ricklon/coglet/README.md

# Coglet

Coglet is a small talking robot head built to be an **MCP device for
[agent-hub](https://github.com/ricklon/agent-hub)**. It has a three-axis neck,
two-axis eyes, a shared top-lid servo, a jaw and two ears: nine hobby servos on
a PCA9685. There's a microphone and speaker for voice, and an optional camera on
the S3 build. The brain is a Seeed XIAO ESP32. The C3 runs this repo's own firmware, which
speaks the [xiaozhi-esp32](https://github.com/78/xiaozhi-esp32) protocol that
agent-hub serves; the S3 still runs a fork of xiaozhi-esp32 itself.

You don't program Coglet directly. It checks in with agent-hub, opens a voice
session, and advertises its abilities as MCP tools. The hub's persona hears what
people say, decides what to do, and calls `self.coglet.gaze`,
`self.coglet.animate` and the rest on the robot.

```
 person ──voice──▶ Coglet ──xiaozhi WebSocket (audio + MCP)──▶ agent-hub ──▶ LLM persona
                    ▲                                              │
                    └──────────── tools/call self.coglet.* ◀───────┘
```

## Supported boards

The S3 is the primary board and supports everything. The C3 and C6 can be used
with the project but can't do every feature. All three take the same wiring,
pad for pad ([hardware/WIRING.md](hardware/WIRING.md)).

| | S3 (XIAO ESP32-S3 Sense) | C3 (XIAO ESP32-C3) | C6 (XIAO ESP32-C6) |
|---|---|---|---|
| Role | Primary | Reduced | Reduced |
| Voice session, MCP tools, servo control | Yes | Yes | Builds; not run on a robot yet |
| Camera | Yes | No | No |
| Wake word | Yes ("Computer", or a phrase you choose) | No | No |
| Firmware | The xiaozhi-esp32 fork (`just build s3`) | This repo's `firmware/app` (`just build c3`) | This repo's `firmware/app` (`just build c6`) |
| Web Programmer build | `coglet` | `coglet-c3` | `coglet-c6` (untested on a robot) |

A tool change on one board is mirrored on the other, except tools that need the camera or the wake word.

| | |
|---|---|
| Coglet C3 (XIAO ESP32-C3) | On the bench, talking to agent-hub on the fork firmware; servos being fitted and calibrated from the base upward. The new `firmware/app` builds but hasn't run on the robot yet |
| Coglet S3 (XIAO ESP32-S3 Sense) | Builds, in two versions: wake word "Computer", or a phrase you choose ("Hey Coglet" to start). Detects its camera (OV2640, OV3660 or OV5640) at boot. Not yet physically qualified |
| Mechanism | Nine roles defined (confirmed 2026-09-15). Servos fitted one at a time; a partly built robot is normal |

No servo gives position feedback. Every position the firmware reports is the
last one it *commanded*, not a measurement. The **servo-rail switch is the
emergency stop**.

## Quick start

1. **Build it.** The [guided build](https://ricklon.github.io/coglet/) walks through parts, flashing, wiring one wire at a time, checks, agent-hub and calibration. The same steps are in [docs/ASSEMBLY.md](docs/ASSEMBLY.md); pins are in
   [hardware/WIRING.md](hardware/WIRING.md). The Fritzing
   schematic is [hardware/esp32c3-voice-agent.fzz](hardware/esp32c3-voice-agent.fzz)
   (older than the pad map in WIRING.md; the pad map wins).
2. **Flash it.** Servo supply off. Use the Web Programmer
   (Chrome or Edge), or build from source:
   ```bash
   just build c3     # firmware/app (or c6, for the XIAO ESP32-C6)
   just flash c3 /dev/ttyACM0
   just setup        # S3 only: fetch the xiaozhi-esp32 fork (submodule)
   just build s3     # or s3-phrase: your own wake phrase
   ```
   Details, including how to run the Web Programmer locally, are in
   [docs/FLASHING.md](docs/FLASHING.md).
3. **Connect it to agent-hub.** On the serial console:
   ```
   !wifi YourSSID YourPassword
   !server http://HUB_HOST:8003/xiaozhi/ota/
   ```
   It shows up on the hub dashboard with its `self.coglet.*` tools. See
   [docs/AGENT-HUB.md](docs/AGENT-HUB.md).
4. **Calibrate before anything moves.** Every boot is released with no roles
   mapped. Map and measure each servo, one at a time:
   [docs/CALIBRATION.md](docs/CALIBRATION.md).

## MCP tools

What agent-hub, Claude or any MCP client can call. MCP is the robot's one
interface: every command is a tool.

| Group | Tools |
|---|---|
| Motion (engaged) | `self.coglet.gaze`, `head`, `jaw`, `ears`, `lids`, `blink`, `animate` |
| Stopping | `self.coglet.stop`, `release` |
| Modes | `self.coglet.engage`, `calibrate` |
| Calibration (released or calibration mode) | `self.coglet.fit`, `configure`, `lid_coupling`, `identify`, `explore`, `nudge`, `mark`, `confirm`, `save`, `servo`, `jog`, `test` |
| Diagnostics | `self.coglet.state`, `export`, `scan` |
| Voice and audio | `self.voice.quiet`, `self.voice.restart`, `self.voice.wake_word` (S3), `self.audio_speaker.set_volume`, `self.audio_speaker.test_tone`, `self.audio_mic.status`, `self.audio_mic.set` |
| Device | `self.get_device_status`, `self.device.status`, `self.wifi.list`, `self.wifi.add`, `self.wifi.remove`, `self.hub.set_server`, `self.reboot` |

Both boards have every tool; a few S3 arguments are strings (see
[OPERATION.md](docs/OPERATION.md#device-commands)). The S3 adds
`self.camera.take_photo` when a camera is detected.

Animations: `look`, `roll`, `side_eye`, `wink`, `surprise`, `sleepy` for the
eyes; `nod`, `shake`, `tilt`, `perk`, `droop`, `talk`, `look_around` for the
rest of the head. Every position stays inside each servo's calibrated window.
Anything with hub access can engage the robot, so the **servo-rail switch**
is the stop that doesn't depend on software. The full list, with the serial
form of each command, is in [docs/OPERATION.md](docs/OPERATION.md#robot-commands).

## Repository layout

```
firmware/
  app/                 C3 firmware: Wi-Fi, agent-hub check-in, voice session, Opus, MCP, console
  coglet_controller/   servo controller: PCA9685, calibration, motion, animations
  tests/               host tests: the real controller against a fake ESP-IDF
  xiaozhi-esp32/       submodule: the xiaozhi fork, still used for the S3
hardware/              Fritzing schematic, wiring and parts
web-programmer/           the guided build site: overview, parts, flashing (esp-web-tools), wiring guide, serial console
scripts/               firmware packaging for the Web Programmer and releases
tools/                 calibration restore-command generator
docs/                  agent-hub, operation, calibration, flashing, qualification
```

On the C3, everything is in this repo: `firmware/app` speaks agent-hub's
xiaozhi protocol itself, with Opus from Espressif's `esp_audio_codec`. On the
S3, the voice stack, Wi-Fi, OTA and MCP server still come from the xiaozhi fork,
which holds a thin board layer. [docs/decisions.md](docs/decisions.md) explains
both.

## Documentation

**Follow current work:** [Build progress](docs/BUILD-PROGRESS.md) lists completed
milestones, the next action, pending input and the latest CAD preview.

Builder readiness, missing mechanical assets and the installation plan are
tracked in [docs/BUILD-REVIEW.md](docs/BUILD-REVIEW.md). CAD source conventions
live in [hardware/mechanical](hardware/mechanical/README.md), with
[SolidCraft CLI and MCP setup](docs/SOLIDCRAFT.md).

| Doc | What it covers |
|---|---|
| [docs/AGENT-HUB.md](docs/AGENT-HUB.md) | **Start here.** Check-in, MCP discovery, the tools, listen mode, driving Coglet from Claude Code |
| [docs/ASSEMBLY.md](docs/ASSEMBLY.md) | Putting it together: boards, harness, power, first power-up, servos base upward |
| [docs/CARRIER-STEPS.md](docs/CARRIER-STEPS.md) | The perfboard carrier, one link per step, with its [hole map](docs/CARRIER.md). Design, not yet built |
| [hardware/WIRING.md](hardware/WIRING.md) | Parts, pin maps for C3 and S3, power, `/OE`, bench checks |
| [docs/FLASHING.md](docs/FLASHING.md) | Web Programmer, CLI builds, packaging, releases, backups before reflashing |
| [docs/OPERATION.md](docs/OPERATION.md) | Every command (MCP tool and serial form), release/engage/calibrate, quiet mode |
| [docs/CALIBRATION.md](docs/CALIBRATION.md) | One-servo-at-a-time calibration, backup and restore |
| [docs/QUALIFICATION.md](docs/QUALIFICATION.md) | Staged physical bring-up checklist and the verification record |
| [docs/decisions.md](docs/decisions.md) | Why things are the way they are |
| [docs/roadmap.md](docs/roadmap.md) | What's done and what's next |
| [AGENTS.md](AGENTS.md) | Guidance for coding agents working in this repo |

## Related projects

- [will-cogley/Coglet](https://github.com/will-cogley/Coglet): Will Cogley's
  original mechanical design and print files. This build uses the version
  without TorqueStars, with our own electronics and agent-hub backend.
  C0_6_8 is the selected CAD baseline; non-TorqueStar adaptation is pending. See the
  [mechanical source inventory](hardware/mechanical/UPSTREAM.md).
- [agent-hub](https://github.com/ricklon/agent-hub): the server Coglet is built for.
- [ricklon/xiaozhi-esp32](https://github.com/ricklon/xiaozhi-esp32): the
  firmware fork, carried here as a submodule for the S3. The C3 firmware
  follows its protocol and storage layout.
- [eyemech-esp32-xiao](https://github.com/ricklon/eyemech-esp32-xiao): the
  animatronic eye project Coglet's motion keyframes and lid coupling were
  adapted from. Eyemech serves MCP over HTTP by itself, with no voice. Coglet
  rides the xiaozhi voice session instead.

## License

Unless otherwise marked, this project's original material is licensed under
**[CC BY-NC 4.0](https://creativecommons.org/licenses/by-nc/4.0/)**
(Creative Commons Attribution-NonCommercial 4.0 International).
See [LICENSE](LICENSE) for the full terms and [NOTICE.md](NOTICE.md) for scope,
upstream attribution and third-party exceptions.

Original Coglet mechanical designs are by Will Cogley / NMRobotics LTD and
retain their upstream CC BY-NC 4.0 notices. Third-party dependencies retain
their own licenses, including the MIT-licensed xiaozhi-esp32 submodule and
Espressif's `esp_audio_codec` under the Espressif Modified MIT license.
