ricklon/coglet/hardware/wires.csv

id | stage | from | to | suggested_colour | note
J1 | 1 | INMP441 L/R | INMP441 GND | black
J2 | 1 | MAX98357A GAIN | MAX98357A Vin | red | 6 dB gain
W1 | 3 | XIAO 3V3 | INMP441 VDD | orange
W2 | 3 | XIAO 3V3 | PCA9685 VCC | orange
W3 | 3 | XIAO 5V | MAX98357A Vin | red
W4 | 3 | XIAO GND | INMP441 GND | black
W5 | 3 | XIAO GND | MAX98357A GND | black
W6 | 3 | XIAO GND | PCA9685 GND | black
W7 | 4 | XIAO D0 | MAX98357A DIN | white
W8 | 4 | XIAO D1 | MAX98357A BCLK | yellow
W9 | 4 | XIAO D2 | MAX98357A LRC | green
W10 | 4 | MAX98357A + | Speaker + | red
W11 | 4 | MAX98357A − | Speaker − | black
W12 | 5 | XIAO D1 | INMP441 SCK | yellow
W13 | 5 | XIAO D2 | INMP441 WS | green
W14 | 5 | XIAO D3 | INMP441 SD | blue
W15 | 6 | XIAO D4 | PCA9685 SDA | violet
W16 | 6 | XIAO D5 | PCA9685 SCL | grey
W17 | 7 | XIAO D10 | PCA9685 /OE | brown
W18 | 8 | PCA9685 V+ | Servo supply V+ | red | through the switch
W19 | 8 | PCA9685 GND | Servo supply GND | black
