ricklon/coglet/hardware/mechanical/reference/parts/STRUCTURAL-PARTS.md

# Structural plate: isolated part views

Derived views of Will Cogley / NMRobotics LTD geometry, CC BY-NC 4.0.
See [upstream provenance](../../UPSTREAM.md). IDs refer to the pinned C0_6_8 pack.
Views are independently fitted, so image sizes cannot be compared as a scale.
Upstream names are preserved. Functional identifications require confirmation.

## C068-O20-P14 — Full - BottomPlug.stl

Mesh-local bounding box: 38.281 × 29.349 × 16.3 mm.

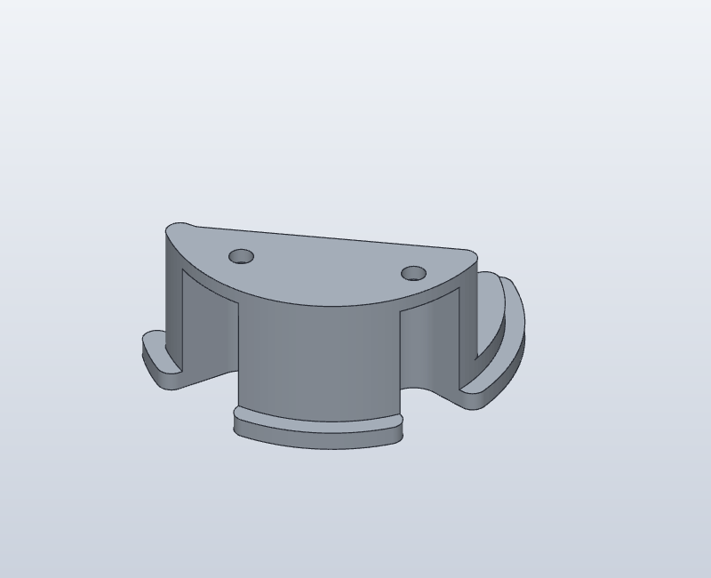
[picture p16: hardware/mechanical/reference/parts/C068-O20-P14.png]
C068-O20-P14


## C068-O20-P15 — Full.stl_7

Mesh-local bounding box: 99.533 × 97.237 × 75.793 mm.

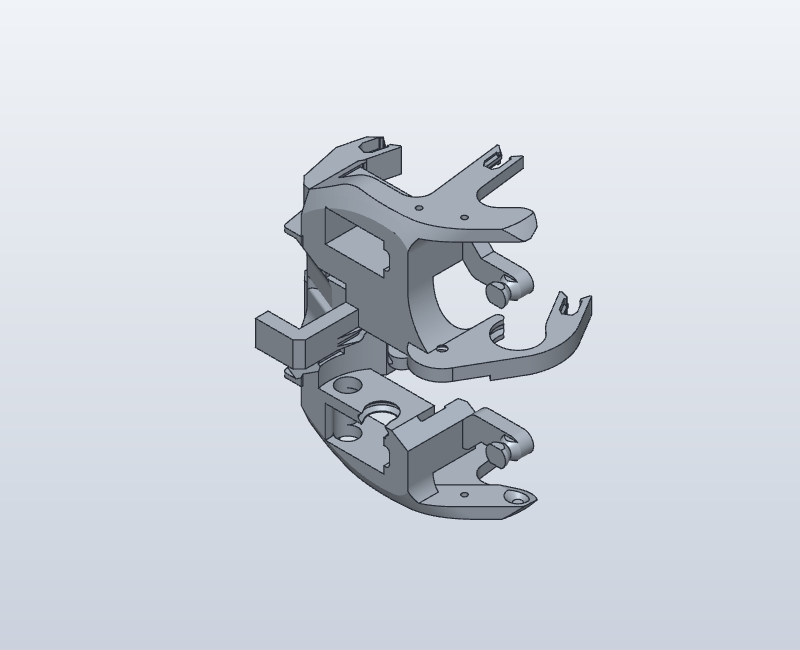
[picture p17: hardware/mechanical/reference/parts/C068-O20-P15.png]
C068-O20-P15


## C068-O20-P16 — Full - Part 24.stl

Mesh-local bounding box: 101.683 × 84.722 × 46.444 mm.

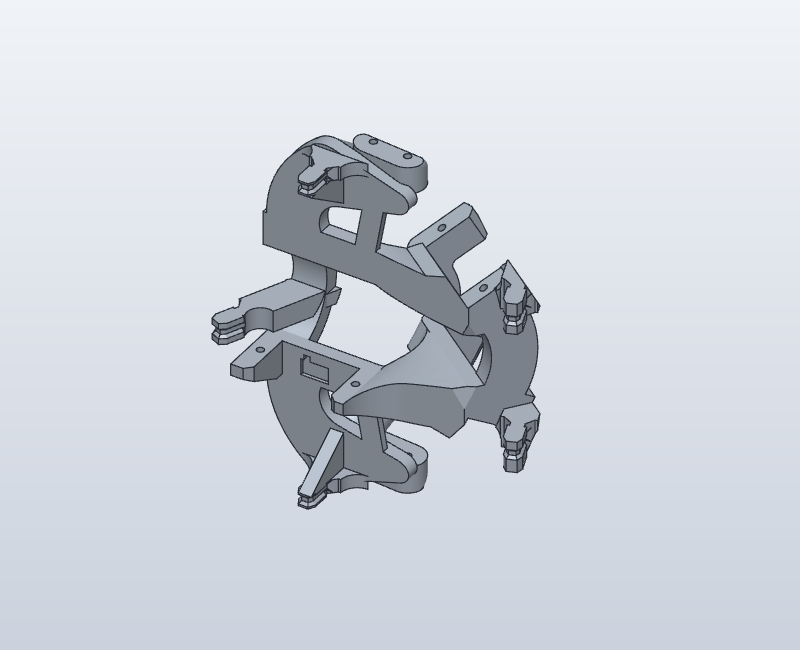
[picture p18: hardware/mechanical/reference/parts/C068-O20-P16.png]
C068-O20-P16


## C068-O20-P17 — Full - Foot (1).stl

Mesh-local bounding box: 92.0 × 92.0 × 27.75 mm.

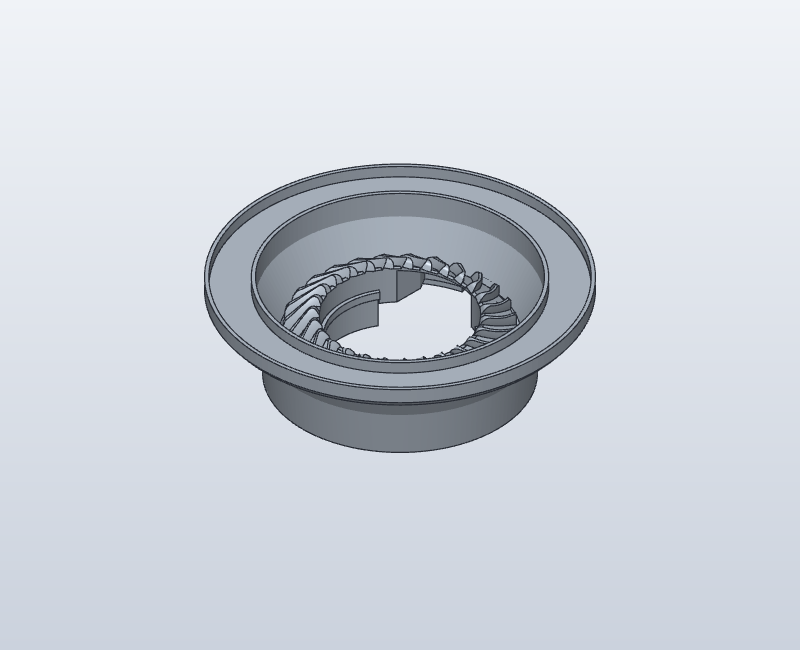
[picture p19: hardware/mechanical/reference/parts/C068-O20-P17.png]
C068-O20-P17


## C068-O20-P18 — Full (9).stl_3

Mesh-local bounding box: 105.822 × 96.0 × 33.85 mm.

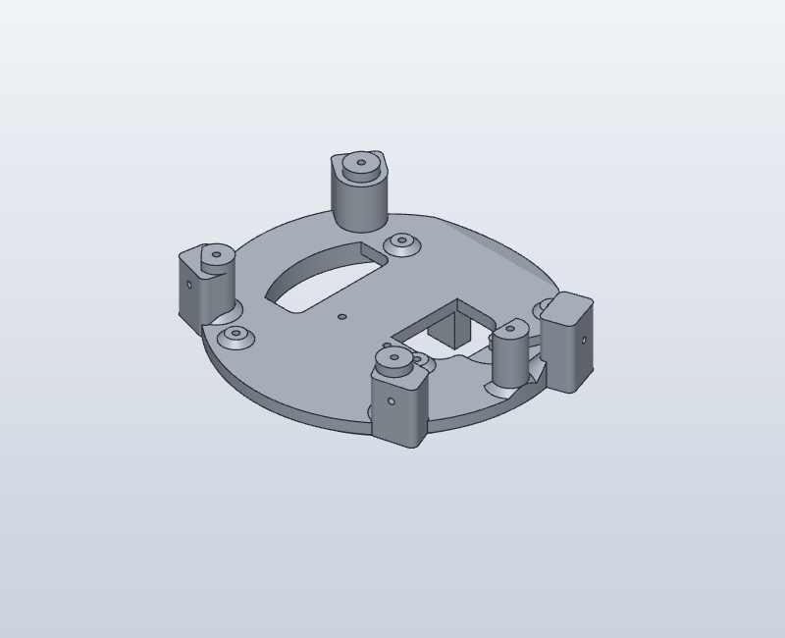
[picture p20: hardware/mechanical/reference/parts/C068-O20-P18.png]
C068-O20-P18


## C068-O20-P19 — Full (9).stl_2

Mesh-local bounding box: 110.964 × 80.808 × 45.999 mm.

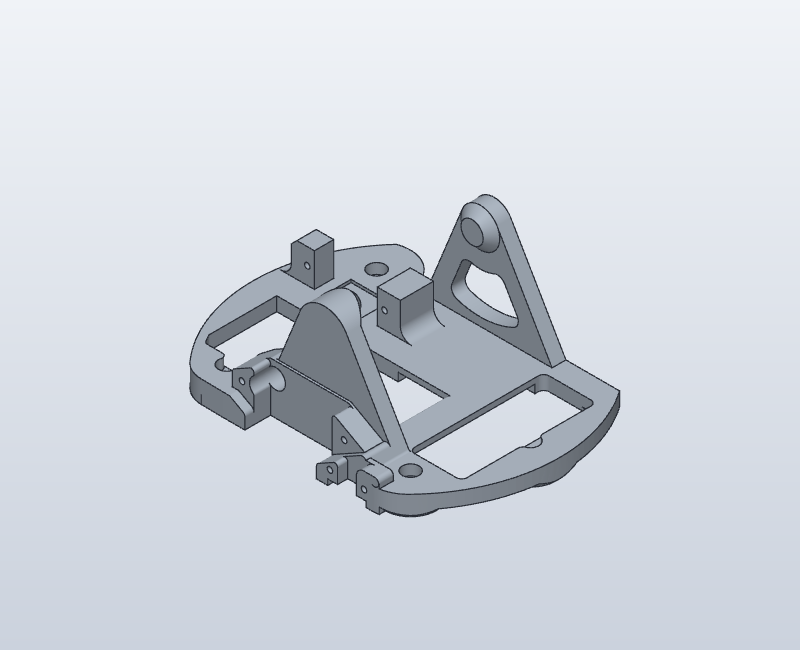
[picture p21: hardware/mechanical/reference/parts/C068-O20-P19.png]
C068-O20-P19
