ricklon/coglet/hardware/mechanical/exports/servo-diameter-coupon.step

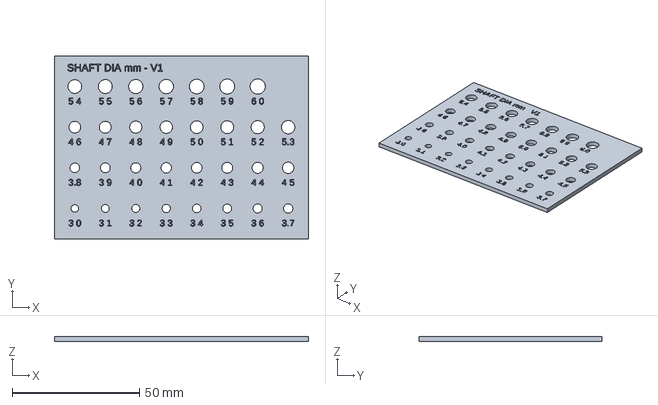
[picture p22: CAD file, 2026-11-11]
hardware/mechanical/exports/servo-diameter-coupon.step
100.0 x 72.0 x 2.00 mm
