ricklon/coglet/hardware/mechanical/exports/carrier-datums.step

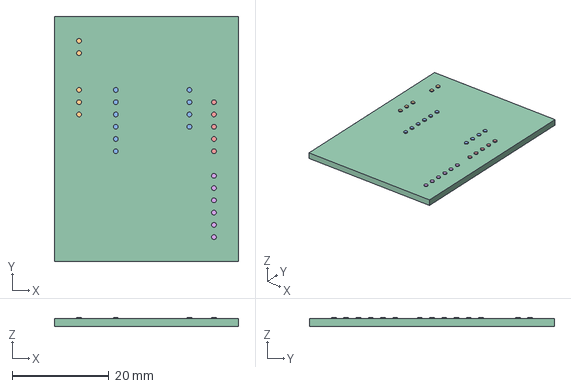
[picture p23: CAD file, 2026-11-11]
hardware/mechanical/exports/carrier-datums.step
38.1 x 50.8 x 1.80 mm
