ricklon/coglet/(list of files, cad)

Other CAD files:
hardware/mechanical/original/CogletC0_6_8.3mf
hardware/mechanical/reference/coglet-c0_6_8-individual.3mf
hardware/mechanical/original/CogletC0_6_8_Generic.stl
hardware/mechanical/exports/servo-diameter-coupon.stl
