ricklon/coglet/hardware/WIRING.md

# Coglet wiring and parts (S3, C3 and C6)

Wiring, parts and power for both Coglet profiles. The pin numbers the firmware
compiles against are `firmware/app/main/board.h` (C3) and, in the xiaozhi
fork, `firmware/xiaozhi-esp32/main/boards/coglet/config.h` (S3). If this page
and those files disagree, the files win; fix this page. The physical pads are
the same on both boards; only the GPIO numbers behind them differ.

The Fritzing schematic for the C3 build is
[esp32c3-voice-agent.fzz](esp32c3-voice-agent.fzz) (open it in
[Fritzing](https://fritzing.org/)). It was drawn from the C3 as first built and
predates the standard pad map below, so it may show D2/D3 and D4/D5 the old way
round: where it disagrees, the pad map wins.

Other Fritzing drawings are in `docs/`:
[xiaesp32-s3-voice-agent.fzz](../docs/xiaesp32-s3-voice-agent.fzz) (the S3, which
sets the pad map), [xiaesp32-c3-voice-agent.fzz](../docs/xiaesp32-c3-voice-agent.fzz),
and two that aren't Coglet boards:
[xiaesp32-c6-voice-agent.fzz](../docs/xiaesp32-c6-voice-agent.fzz) and
[xiaozhi-assistant.fzz](../docs/xiaozhi-assistant.fzz).

## Block diagram (both profiles)

```
                 +---------------------------+
   USB  ---------+  XIAO ESP32-S3 / C3       |
 (console,       |                           |
  5V in)         |  I2S: BCLK, WS shared     |
                 |    DOUT --> amp           +---> MAX98357A ---> 4-8 ohm speaker
                 |    DIN  <-- mic           |     (amp Vin 5V)
                 |                           +<--- INMP441 mic (3V3)
                 |                           |
                 |  I2C: SDA, SCL  ----------+---> PCA9685 (0x40, 50 Hz)
                 |  GPIO: /OE     -----------+---> PCA9685 /OE (active low)
                 |                           |         |
                 |  (S3 only) DVP camera     |         |  9 servos, fitted
                 +---------------------------+         |  bottom-up:
                                                       +--> base      (ch0)
     servo supply (switched, 4.8-6 V) --> PCA V+ ------+--> neck_tilt
     common ground with the XIAO                       +--> neck_roll
                                                       +--> eye_pan
                                                       +--> eye_tilt
                                                       +--> lids (both top lids)
                                                       +--> jaw
                                                       +--> ear_left
                                                       +--> ear_right
```

Logic and servo power are separate. PCA9685 logic VCC is 3.3 V from the XIAO;
servo V+ comes from its own switched supply. Grounds are common. Never take
servo current from the XIAO regulator or the USB 3.3 V rail.

## Parts

| Part | Role | Notes |
|---|---|---|
| Seeed XIAO ESP32-S3 Sense | S3 Coglet MCU | PSRAM, camera connector |
| Seeed XIAO ESP32-C3 | C3 Coglet MCU | no PSRAM, no camera, no user LED |
| INMP441 | I2S microphone | 3.3 V, L/R pin selects the I2S slot |
| MAX98357A | I2S class-D amp | 5 V, SD pin sets gain and shutdown |
| PCA9685 breakout | 16-channel servo PWM | address 0x40, 100 kHz I2C, ~50 Hz output |
| Hobby servos x9 | base, neck_tilt, neck_roll, eye_pan, eye_tilt, lids (one servo for both top lids), jaw, ear_left, ear_right | model not yet recorded — see Unknowns |
| Servo supply | switched V+ for PCA | sized for the fitted servos; physical switch is the emergency stop |
| Camera (S3 only) | OV2640 / OV3660 / OV5640 | detected at boot; menuconfig can pin one model or turn it off |

## Pad map (every board)

Wire every Coglet the same way, pad for pad. Moving a robot between a C3 and
an S3 is a board swap, not a rewire: each board's firmware maps the same pads
to its own GPIOs.

| Function | XIAO pad | C3 GPIO | C6 GPIO | S3 GPIO |
|---|---|---|---|---|
| Amp DIN (speaker data) | D0 | 2 | 0 | 1 |
| I2S BCLK: amp BCLK and mic SCK | D1 | 3 | 1 | 2 |
| I2S WS: amp LRC and mic WS | D2 | 4 | 2 | 3 |
| Mic SD (data out of the mic) | D3 | 5 | 21 | 4 |
| PCA9685 SDA | D4 | 6 | 22 | 5 |
| PCA9685 SCL | D5 | 7 | 23 | 6 |
| PCA9685 /OE | D10 | 10 | 18 | 9 |

The S3 Coglet sets this layout; SDA/SCL are the XIAO's default I2C pads. Two
pairs are easy to swap, and each fails in a recognisable way:

- **D2 is WS, D3 is mic data.** Swapped, the amp runs with no LRC (steady hiss)
  and capture samples a clock line, reading flat zero.
- **SDA on D4, SCL on D5.** Swapped, no address on the bus answers at all.

> **The C3 bench robot was wired with both pairs the other way round** (D2 mic,
> D3 WS, SCL on D4, SDA on D5) and ran like that on the fork firmware until
> 2026-10-20. Swap both pairs before flashing current firmware onto it.

### C3 specifics (`coglet-c3`)

- Boot button on GPIO9. GPIO8 and GPIO9 are strapping pins, so /OE uses D10
  (GPIO10).
- No user-controllable LED; an external one is tracked in
  ricklon/xiaozhi-esp32#8.

### C6 specifics (`coglet-c6`)

- Build: `just build c6` (`firmware/app`, target `esp32c6`). No camera and no
  wake word, like the C3.
- Boot button on GPIO9, a strapping pin, so it is only ever read. /OE uses D10
  (GPIO18), which is not a strapping pin.
- The XIAO ESP32-C6 sends its radio through an RF switch: **GPIO3** low enables
  it and **GPIO14** low picks the on-board antenna. The firmware drives both
  low at boot, before Wi-Fi starts. Neither is a pad. This is why the C6 map
  can't reuse the C3's GPIOs: the C3's D1 is GPIO3.
- D0, D1, D2, D3 and D4 follow the XIAO ESP32-C6 pinout as used in
  cam-rotation-starter; D5 (GPIO23) and D10 (GPIO18) are from Seeed's pinout.
  **This map hasn't been checked on hardware.**

### S3 Sense specifics (`coglet`)

| Function | GPIO |
|---|---|
| User LED (active low) | 21 |
| Boot button | 0 |
| Camera SCCB SDA / SCL | 40 / 39 |
| Camera D0..D7 | 15, 17, 18, 16, 14, 12, 11, 48 |
| Camera XCLK / PCLK / VSYNC / HREF | 10 / 13 / 38 / 47 |

Servo I2C is controller **1** so the camera keeps controller 0. /OE on GPIO9 is
not the camera's XCLK GPIO10. Use the external I2S microphone, not the Sense
board's PDM mic; GPIO1–4 stay audio. The Sense microSD slot is not enabled —
keep SD circuitry off the servo I2C pins. The S3 pad map hasn't been checked on
hardware yet.

## Servo channels

Every Coglet uses the same PCA9685 channel per role, in role order from the
base up. The firmware carries this table (`SERVO_ROLE_CHANNELS` in
`firmware/app/main/board.h`, and the default in `CogletPins`), and
`!coglet fit ROLE` uses it.

| Channel | Role | MCP motion |
|---|---|---|
| 0 | `base` | head (pan) |
| 1 | `neck_tilt` | head (tilt) |
| 2 | `neck_roll` | head (roll) |
| 3 | `eye_pan` | gaze |
| 4 | `eye_tilt` | gaze |
| 5 | `lids` (both top lids) | lids, blink, gaze tracking |
| 6 | `jaw` | jaw |
| 7 | `ear_left` | ears |
| 8 | `ear_right` | ears |
| 9–15 | spare | |

A listed channel isn't assigned until the servo is fitted and `fit` is run, so
a partly built robot only drives what's there.

## Power and safety

- Servo V+ is a separate switched supply; that switch is the real emergency stop.
- PCA9685 logic VCC 3.3 V, I2C pull-ups to 3.3 V, grounds common.
- /OE is active low. The firmware drives it high before configuring the PCA, so
  outputs stay off across a reset **only if /OE is actually wired** and pulled up
  to the PCA logic rail. Many breakouts ship with /OE pulled down; then release
  depends on I2C alone and cannot stop PWM if that bus fails.
- For reset-safe inhibition: wire D10 to /OE and replace the breakout's
  pull-down with a pull-up (e.g. 10 kΩ) to the PCA logic 3.3 V rail. Inspect
  the actual breakout before changing resistors, and scope /OE across warm and
  cold resets before relying on it.
- Every boot starts released with no pose commanded, whatever is stored in NVS.

## Bench checks

```bash
!status                  # firmware, IP, heap
!coglet scan             # expect 0x40 on the configured pins
!coglet state            # released, pca_initialized, per-role mapping
!mic                     # peak meter; zero means wiring, not code
!speaker test            # chime through the amp
```

`!coglet scan <sda> <scl>` rebuilds the bus on other pins, which distinguishes a
swapped pair (silent bus) from a wrong address or an unpowered board. It tears
the bus down, so reboot afterwards.

## Unknowns to confirm at the bench

1. **Servo model** and its true pulse range. The firmware's 1000-2000 us default
   is a placeholder, which is why a 70-110 degree window moves so little.
2. **Servo supply** voltage and current rating.
3. **Rewiring to the standard channels.** Only `base` was recorded as fitted
   (ch0, which matches). Any servo already on another channel either moves to
   its standard channel or is assigned by hand with `configure`.
4. **Is /OE wired** on this breakout, and is it pulled up or down?
5. **Ears**: are they mounted mirrored? If so, "both forward" is two
   opposite angles, which the per-role endpoints can express.
6. **Camera module marking** on the S3 unit (OV2640 / OV3660 / OV5640).
