ricklon/coglet/(list of files, drawings)

Other design files:
docs/xiaesp32-c3-voice-agent.fzz
docs/xiaesp32-c6-voice-agent.fzz
docs/xiaesp32-s3-voice-agent.fzz
docs/xiaozhi-assistant.fzz
hardware/esp32c3-voice-agent.fzz
