ricklon/coglet/(commit log)

2026-10-20 Coglet: robot head for agent-hub, with its own C3 firmware
    The product home for Coglet: hardware and wiring, docs, the servo controller
    and its host tests, the web flasher and release workflow.
    - firmware/coglet_controller: PCA9685 servo controller (nine roles, released
    boot, builder mode, NVS calibration), host-tested against a fake ESP-IDF.
    - firmware/app: new ESP-IDF firmware for the C3 that speaks agent-hub's
    xiaozhi protocol directly (check-in, voice WebSocket, Opus via
    espressif/esp_audio_codec, MCP, heartbeat, serial console). Keeps the
    fork's NVS layout. Builds; not yet run on a robot.
    - firmware/xiaozhi-esp32: the fork as a submodule, now only for the S3,
    pinned to the sp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
    [esp32c3-voice-agent.fzz, partitions.csv]
2026-10-20 Standard servo and pad maps; flasher walkthrough
    - One pad map for every board, set by the S3: D0 amp DIN, D1 BCLK, D2 WS,
    D3 mic SD, D4 SDA, D5 SCL, D10 /OE. firmware/app's C3 pins move to match
    (WS GPIO4, mic GPIO5, SDA GPIO6, SCL GPIO7); the bench C3 needs D2/D3 and
    D4/D5 swapped. WIRING.md and the flasher show one table with a GPIO
    column per board.
    - Standard servo channels in code: role n on PCA9685 channel n
    (SERVO_ROLE_CHANNELS, and the CogletPins default). New local command
    `!coglet fit ROLE` assigns a fitted servo from it, unconfirmed with a
    90/90 window; nothing is assigned just because it's listed. Host tests
    cover it.
    - The web flasher walks through building the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
    [board.h, coglet_controller.cc, coglet_controller.h, console.cc, main.cc, test_controller.cc]
2026-10-20 docs: add the Fritzing drawings for the S3, C3 and related boards
    [xiaesp32-c3-voice-agent.fzz, xiaesp32-c6-voice-agent.fzz, xiaesp32-s3-voice-agent.fzz, xiaozhi-assistant.fzz]
2026-10-20 Add !coglet test: sweep servos through their calibrated windows
    `!coglet test ROLE` sweeps one role centre, low, high, centre (~5 s);
    with no role it tests every calibrated role in turn, base upward. Local
    and builder-mode only, never outside the calibrated window, and not an MCP
    tool. It runs on the motion timer, so release, stop and any other builder
    move end it at once. Host tests cover the window, the order and the
    interruptions.
2026-10-21 MCP as the one interface; all nine servos driven; Web Programmer; assembly guide
    - Every robot command is an MCP tool (~40): motion, engage/builder,
    calibration, servo test, diagnostics, quiet, audio, Wi-Fi, hub URL,
    reboot. The serial console runs the same commands through the same code.
    The builder web page is gone. tools/list pages through nextCursor.
    - New motion for the rest of the head: head (pan/tilt/roll), jaw, ears,
    lids, and animations nod, shake, tilt, perk, droop, talk, look_around.
    The pose now covers all nine roles; unfitted roles are skipped and
    release forgets the pose. The lid-coupling calibration command is now
    lid_coupling.
    - Quiet mode (builder turns it on)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
    [coglet_controller.cc, coglet_controller.h, console.cc, console.h, hub.cc, mcp.cc]
2026-10-27 Builder mode is calibration mode, and it keeps the MCP session
    The mode that turns servo outputs on for endpoint hunting and servo tests
    is now "calibrate": !coglet calibrate, self.coglet.calibrate, and
    "calibrating" in state.
    It works over the serial console before there's any hub, so a robot can
    be calibrated straight after flashing, and over MCP once agent-hub is
    connected. CALIBRATION.md now says so.
    Fork bump (feat/coglet-split 8b03cfc): the S3 keeps its voice session,
    and MCP with it, open in quiet mode instead of closing it, reopens a
    dropped session without listening, and has self.voice.quiet. Entering
    calibration mode over MCP no longer cuts the S3 off with its servos
    powered.
    Al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
    [coglet_controller.cc, coglet_controller.h, mcp.cc, mcp.h, session.cc, session.h, test_controller.cc]
2026-10-27 S3: camera detected at boot, wake word with the session open, full MCP tools
    Fork bump (4e05235):
    - The camera could never start: its SCCB took the servos' I2C
    controller, and its clock shared the LED's LEDC channel. Both moved.
    It's now detected at boot (OV2640, OV3660 or OV5640) instead of staying
    off until a build confirms the model.
    - The S3 waits for the wake word "Computer" with the voice session, and
    MCP, open, and goes back to waiting 12 s after the last voice.
    - The S3 has the C3's voice and device tools, so both boards expose the
    same tool names.
    Docs: decisions, AGENT-HUB listening, OPERATION S3 argument notes,
    README status, WIRING, QUALIFICATION stage 4, the Web Prog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
2026-10-27 S3 typed wake phrase build ("Hey Coglet"), offered beside "Computer"
    The S3 now comes in two builds that differ only in the wake word:
    - s3: the trained "Computer" model.
    - s3-phrase: a typed phrase through English MultiNet, "hey coglet" by
    default, changed per robot with !wake or self.voice.wake_word.
    just build/flash s3-phrase, a packager entry (manifest-coglet-phrase.json),
    a release matrix entry, and a second S3 card on the Web Programmer.
    Fork bump (7504bce): both S3 builds use a new partition table with one
    4 MB app slot and 3.9 MB of assets, since MultiNet's English model didn't
    fit the old 2 MB. NVS keeps its offset, so settings should survive the
    switch; FLASHING.md says to exp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
2026-10-27 docs/AGENT-HUB.md: in step with agent-hub main (139911e)
    The device MCP proxy is on agent-hub main (5f973f6), with the read and
    stop tools exposed by default. The hub stops a reply on abort (966362f)
    and keeps idle sessions open with a keepalive frame (98fb426), which the
    S3 logs as an unknown message type. Troubleshooting rows for a stale
    self_coglet_builder allowlist entry (5d019cc) and for server.websocket
    when the hub runs in Docker or WSL.
2026-11-10 docs/AGENT-HUB.md: note agent-hub's planned device pairing
2026-11-10 Web Programmer: step-by-step wiring guide with diagrams
    Eight stages, each with an SVG drawn from one wire table, a check and the
    common mistake. Linked from the Web Programmer and ASSEMBLY.md.
2026-11-10 Wiring guide: one wire per step, with wire IDs, a wire list and a BOM
    wiring.html now walks 20 wires (J1, W1-W19) one at a time, with a check and
    the common mistake at the end of each stage. hardware/wires.csv lists the same
    wires and scripts/check_wiring.py checks the two agree. hardware/bom.csv is the
    parts list.
    [bom.csv, wires.csv]
2026-11-10 README: board-support table (S3 primary, C3 and C6 reduced)
2026-11-10 C6: pad map, RF switch setup and build for firmware/app
    board.h picks the C3 or C6 pad map from the build target. The XIAO ESP32-C6
    antenna switch (GPIO3, GPIO14) is driven low at boot, before Wi-Fi. just build c6
    uses its own build directory, sdkconfig and dependencies lock. The map has not
    been checked on hardware.
2026-11-10 Web Programmer: C6 card, and the release workflow builds the C6
    The card says the C6 build has not run on a robot and its pin map is unchecked.
2026-11-10 Web Programmer: project overview and one page per stage
    index.html is now a short overview with the order to work in. Parts, flash,
    wiring, check (serial console), connect (agent-hub), build and calibrate each
    have their own page, with a stage bar and Back/Next links.
2026-11-10 Carrier board: perfboard layout, hole map and a step per link
    tools/carrier/carrier.py holds the board model (strips, pins, 10 underside
    links) and checks that it makes exactly the nets in hardware/wires.csv. It
    generates the hole map, a picture per step, docs/CARRIER*.md and the Solder
    page. Design only: not built, and the amp and mic pin orders are assumed.
2026-11-11 Mechanical baseline, license, and build tracking
    Set the project license to CC BY-NC 4.0 (LICENSE, NOTICE.md) with upstream
    and third-party notices, and point the README at the new build docs.
    Add hardware/mechanical: Will Cogley's C0_6_8 print files pinned to an
    upstream commit (UPSTREAM.md), the SolidCraft reference import split into
    individual parts, structural close-ups, a servo diameter sizing coupon with
    STEP/STL exports, and carrier datums for the 3D model. Large model files
    (*.stl, *.3mf, *.sc) are stored with Git LFS.
    Add docs/BUILD-PROGRESS.md, BUILD-REVIEW.md and SOLIDCRAFT.md, and the
    tools that produce the mechanical files.
    The SolidCraft carrier model and its STEP export pre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
    [CogletC0_6_8.3mf, CogletC0_6_8_Generic.stl, carrier-datums.step, coglet-c0_6_8-individual.3mf, servo-diameter-coupon-inspection.json, servo-diameter-coupon-layout.json, servo-diameter-coupon.json, servo-diameter-coupon.step]
2026-11-11 Carrier board: match the prototype, XIAO at the board edge
    Re-lay the ElectroCookie carrier to match the board being built:
    - XIAO pins in rows 1-7 (columns D and H), so its USB-C port sits at the
    row-1 edge. Seeed's land pattern confirms 15.25 mm between pin rows.
    - MAX98357A flat on a straight header in D11-D17. SD unconnected; GAIN
    tied to Vin for 6 dB (new jumper J2 in wires.csv and the wiring page).
    - INMP441 (75 mm wires, L/R tied at the mic) and PCA9685 (90 mm wires)
    land straight in the XIAO's strips, so they need no links. Their
    signal holes are as built; the power and /OE holes are the design's.
    - Six underside links instead of ten.
    Tighten the generator's check: each lin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
    [bom.csv, wires.csv]
2026-11-12 Carrier board: power rails and shared power holes, as built
    Add the prototype's power wiring to the carrier design:
    - Component-side jumpers T1 (I2-H8) and T2 (I3-H9) bring GND and 3.3 V
    down to rows 8 and 9; T3 (E8-F8) and T4 (E9-F9) carry both rails
    across the channel. A new step solders them before the XIAO, since
    H8 sits under the edge of its body.
    - The mic's and the PCA9685's power wires share B8 (GND) and B9 (3.3 V),
    twisted together into one hole each. Only off-board wire ends may
    share a hole; the check fails if two pins do.
    - The /OE pull-up stays on the PCA9685 board.
    - Fix a nondeterministic net-table order (shared holes tied on the sort
    key), which made --check repo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
2026-11-12 Carrier guide: /OE pull-up on the PCA9685's other header
    The PCA9685 breakout repeats its header at both ends. The five lead
    wires use one end; the /OE pull-up (about 10 kohm, /OE to VCC) now goes
    across the other end's header, so the resistor and the wires never
    share a pin. Updated in the carrier guide (steps 1 and the PCA9685 wire
    step), docs/ASSEMBLY.md and the wiring guide's stage 1.
    Checked by the generator and scripts/check_wiring.py only.
